ArturVSS/Repeater_controller/picture/dev_kit_pinout-1.jpg

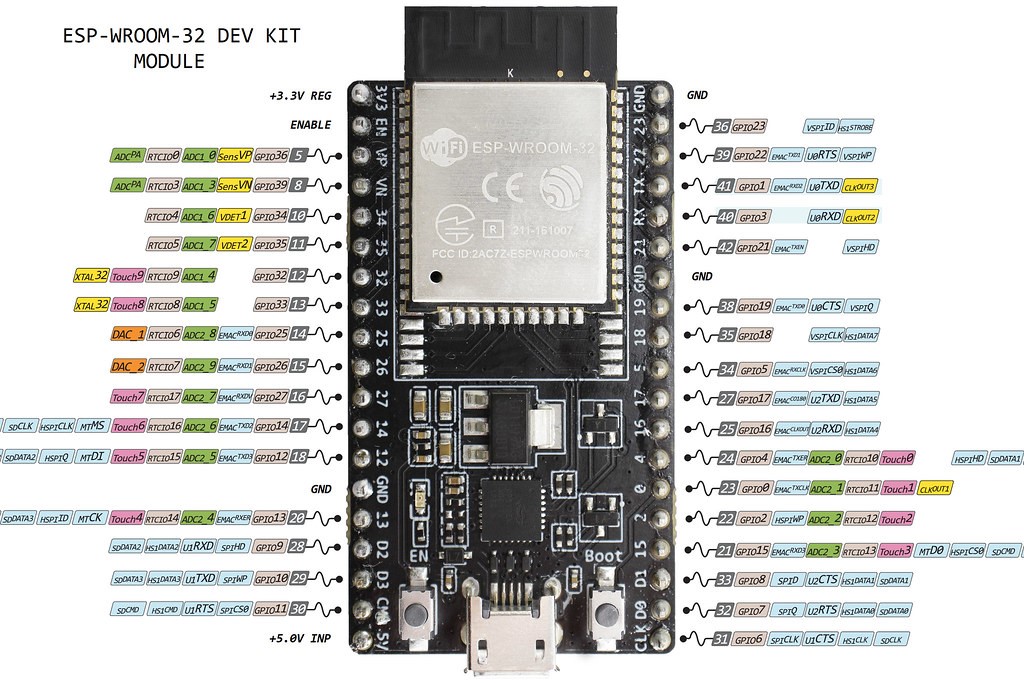
picture/dev_kit_pinout-1.jpg
