ArturVSS/Repeater_controller/picture/ads1115-1.jpg

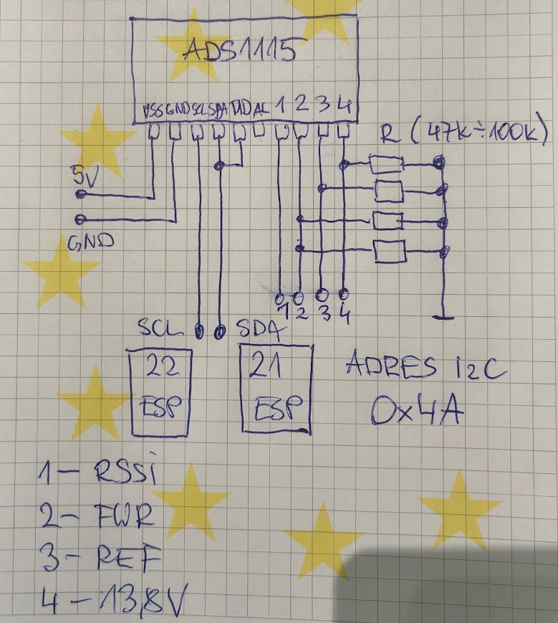
picture/ads1115-1.jpg
