ArturVSS/Repeater_controller/picture/8006216500_1605259069.png

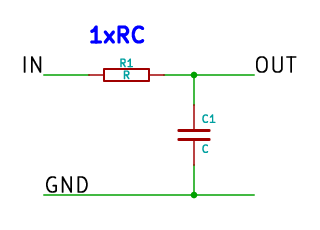
picture/8006216500_1605259069.png
