ArturVSS/Repeater_controller/picture/ADS1115-BOARD.jpeg

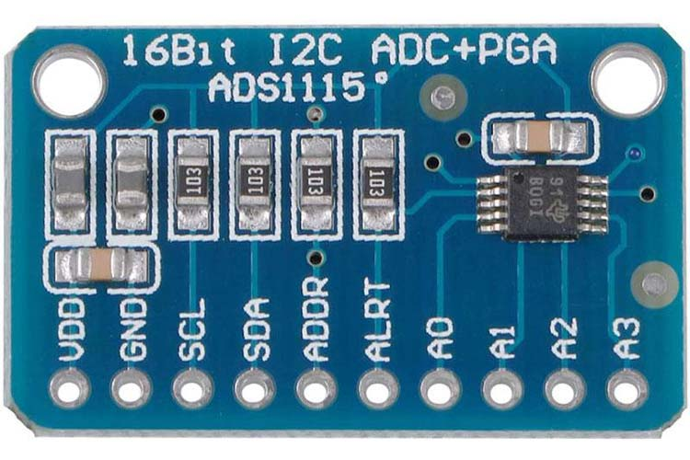
picture/ADS1115-BOARD.jpeg
