ArturVSS/Repeater_controller/picture/dzielnik.png

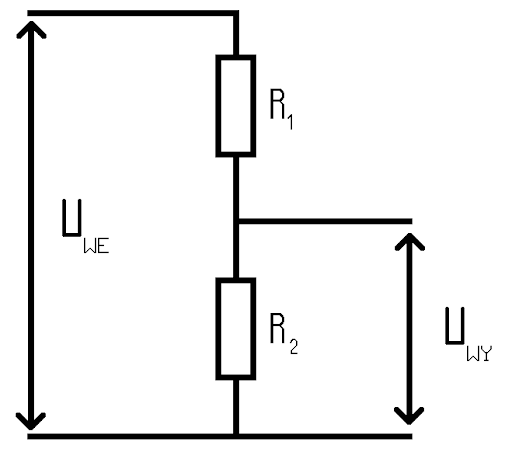
picture/dzielnik.png
