ArturVSS/Repeater_controller/picture/NE567-768x434.jpg

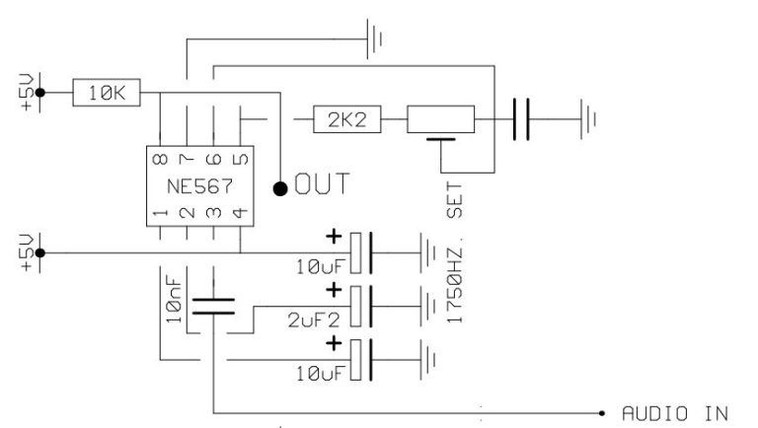
picture/NE567-768x434.jpg
