ArturVSS/Repeater_controller/picture/RSSI-1024x442.jpg

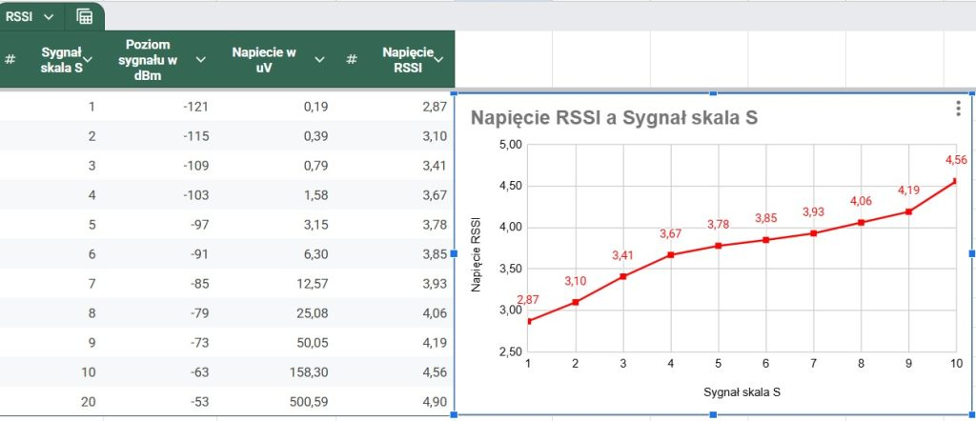
picture/RSSI-1024x442.jpg
