ArturVSS/Repeater_controller/picture/schemat-2.jpg

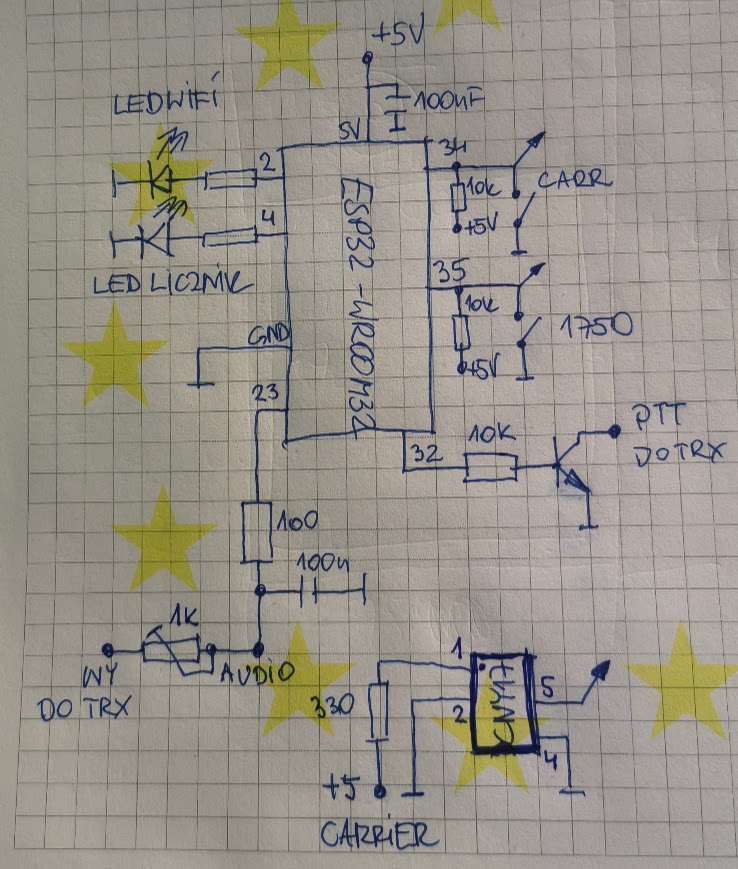
picture/schemat-2.jpg
