ArturVSS/Repeater_controller/picture/www1-1.jpg

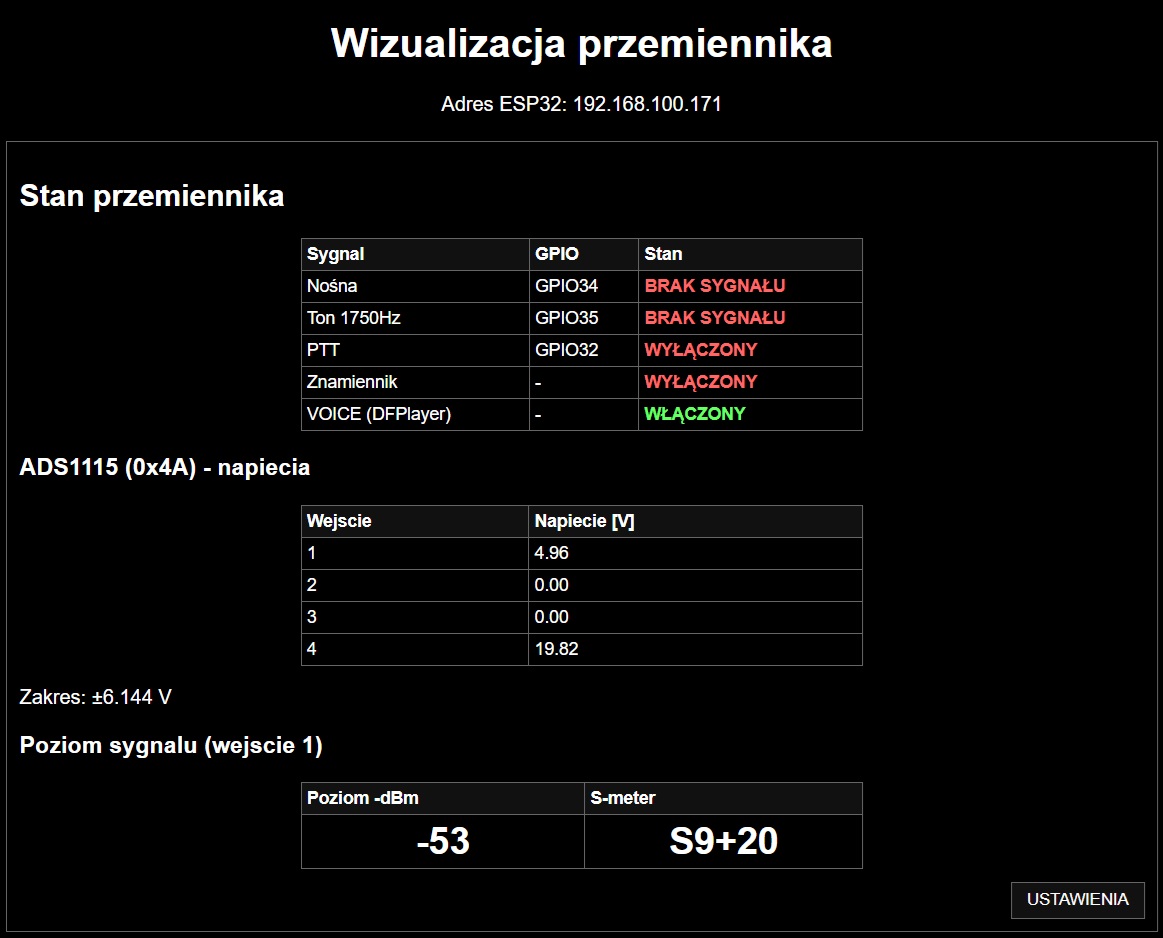
picture/www1-1.jpg
