ArturVSS/Repeater_controller/picture/www2-2.jpg

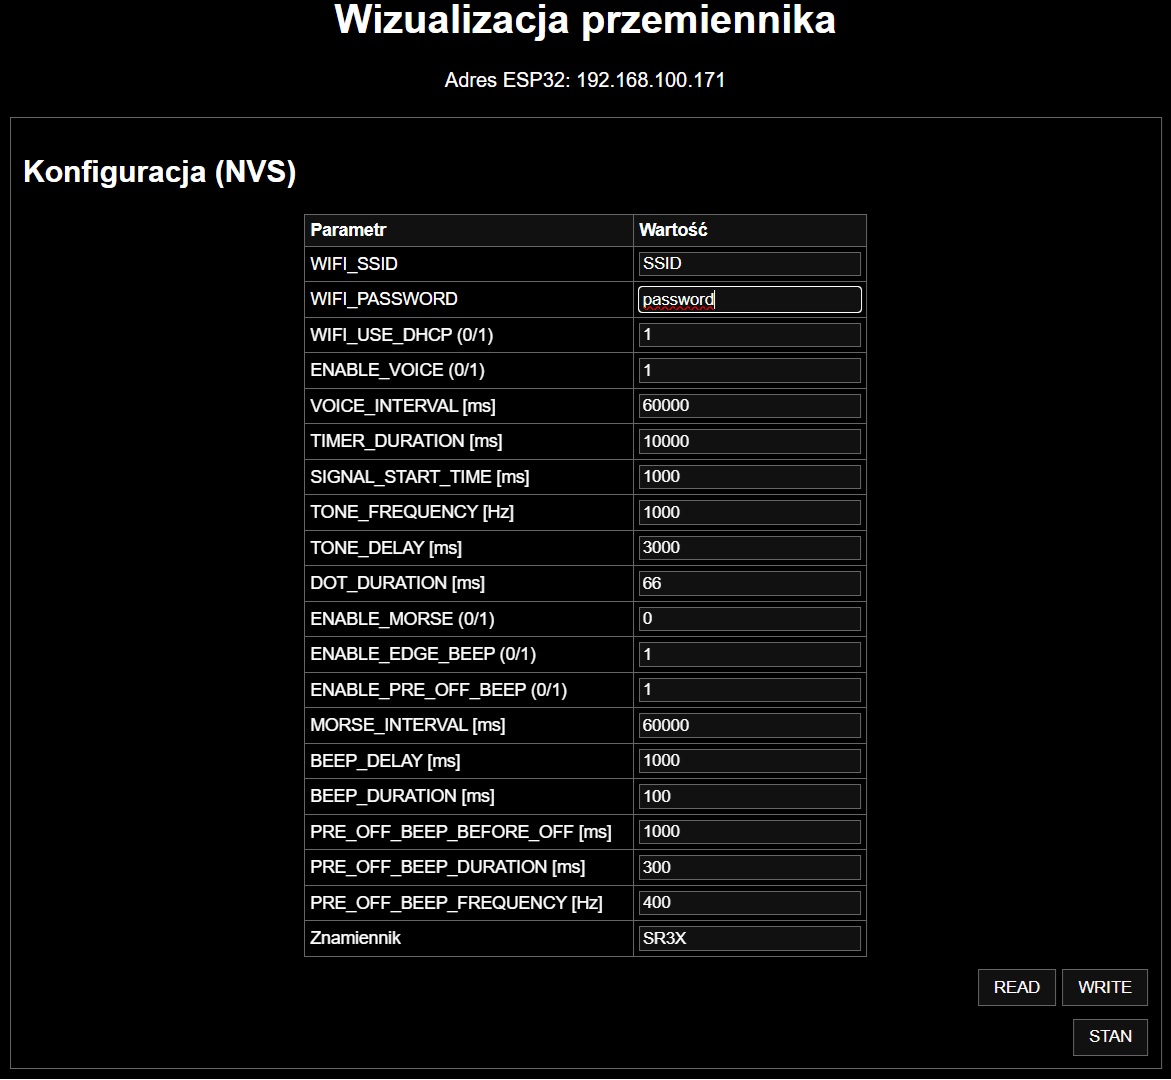
picture/www2-2.jpg
